souadquzmar/SmartHydroponics/TDS_EC_Arduino_Code_Explanation.docx

# TDS & EC Monitoring

Arduino Mega 2560 | Code explanation for an NFT hydroponic greenhouse growing basil and mint

Purpose: Read the analog TDS module, estimate dissolved-solids concentration and electrical conductivity, display the results, and classify the nutrient solution using five EC bands.

# 1. How the program works

The Arduino reads an analog voltage from the sensor on pin A0. It converts this raw reading into volts, applies a temperature correction, estimates TDS (ppm) using a sensor-specific polynomial, and calculates an estimated EC (mS/cm) using a fixed conversion factor. It then prints the measurements and a status message once per second.

# 2. Sensor connection and constants

Code element | Meaning
TDS_PIN = A0 | The sensor module’s analog signal output is connected to Arduino analog pin A0.
VREF = 5.0 | Assumed analog-to-digital reference voltage in volts. This must match the actual Arduino ADC reference.
ADC_RESOLUTION = 1024.0 | A 10-bit Arduino Mega ADC has 1024 possible values: 0 through 1023.
temperature = 25.0 | Fixed water-temperature assumption, in °C. Replace with a real water sensor reading when available.
tdsFactor = 0.5 | Assumed 500-scale TDS-to-EC conversion factor; this is not universal.

Threshold definitions: EC_LOW_CRITICAL = 1.1, EC_LOW = 1.2, EC_HIGH = 1.5, EC_HIGH_CRITICAL = 1.6. All four are expressed in mS/cm. They are initial project settings for established basil and mint, not measurements made by the sensor.

# 3. setup(): initialization

void setup() {
Serial.begin(9600);
pinMode(TDS_PIN, INPUT);
Serial.println("TDS and EC Monitoring System");
Serial.println("Hydroponics: Basil and Mint");
}

setup() runs once when the board powers on or resets. Serial.begin(9600) starts USB serial communication at 9600 baud; set the Serial Monitor to the same rate. pinMode sets A0 as an input. The two print commands identify the system.

# 4. loop(): converting the sensor reading

int analogValue = analogRead(TDS_PIN);
float voltage = analogValue * VREF / ADC_RESOLUTION;

analogRead(A0) returns an integer from 0 to 1023. Multiplying that reading by 5.0 / 1024 estimates the module output voltage. For the previously observed analog reading 154, the displayed voltage is about 154 × 5 / 1024 = 0.752 V. This is the module’s electrical output, not EC itself.

# 5. Temperature compensation

float compensationCoefficient =
1.0 + 0.02 * (temperature - 25.0);
float compensatedVoltage = voltage / compensationCoefficient;

Conductivity depends on water temperature. The program uses an approximate 2% change per °C around 25°C to normalize the voltage. Because temperature is currently fixed at 25°C, the coefficient equals 1.0: no adjustment is actually made. Use a measured temperature for more realistic compensation; the precise behavior also depends on the sensor and solution.

# 6. Calculating TDS and estimating EC

float tdsValue =
(133.42 * pow(compensatedVoltage, 3)
- 255.86 * pow(compensatedVoltage, 2)
+ 857.39 * compensatedVoltage) * 0.5;
float ecValue = tdsValue / (tdsFactor * 1000.0);

The polynomial estimates TDS in parts per million (ppm) from corrected voltage. Its coefficients are associated with a common analog TDS-module example; they are not a universal physics formula for all probes. pow(x, 3) means x cubed and pow(x, 2) means x squared.

Next, the program computes EC from its estimated TDS. With tdsFactor = 0.5: EC (mS/cm) = TDS (ppm) / 500. Thus 600 ppm corresponds to an estimated 1.2 mS/cm. IMPORTANT: EC is not independently measured by this code; the EC and TDS values are two expressions of the same analog estimate.

# 7. Printing the readings

The Serial.print commands output the raw ADC number, voltage (three decimal places), TDS (one decimal place), and EC (three decimal places). Serial.println adds a line break. The final delay(1000) pauses for approximately 1 second between reports. The numbers are intended for observation and debugging.

# 8. Understanding the if / else if conditions

Condition evaluated in order | Displayed status | Displayed recommendation
EC < 1.1 | CRITICALLY LOW | Add nutrients A and B
1.1 ≤ EC < 1.2 | LOW | Monitor EC / nutrients may be needed
1.2 ≤ EC ≤ 1.5 | OPTIMAL | No adjustment needed
1.5 < EC ≤ 1.6 | HIGH | Stop nutrient dosing
EC > 1.6 | CRITICALLY HIGH | Stop nutrients / check dilution

The program checks each condition from top to bottom and executes only the first matching branch. For example, an EC of 0.557 enters the first branch; an EC of exactly 1.2 enters OPTIMAL; exactly 1.5 is also OPTIMAL; exactly 1.6 is HIGH.

There is no separate TDS condition because the program derives EC directly from TDS using the 0.5 factor. Therefore, separate TDS comparisons would repeat the same classification, rather than add a new independent measurement.

# 9. Worked example from your Serial Monitor

Analog: 154
Voltage: 0.752 V
TDS: 278.4 ppm
EC: 0.557 mS/cm
STATUS: CRITICALLY LOW
ACTION: Add nutrients A and B

The measured EC estimate (0.557) is below the first 1.1 threshold, so the code prints CRITICALLY LOW. If this sample was plain source water rather than a mixed nutrient solution, the status should NOT be treated as an instruction to dose immediately.

# 10. Full annotated code

#define TDS_PIN A0
#define VREF 5.0
#define ADC_RESOLUTION 1024.0

float temperature = 25.0; // Assumed water temperature (C)
float tdsFactor = 0.5; // 500 ppm per 1 mS/cm

#define EC_LOW_CRITICAL 1.1
#define EC_LOW 1.2
#define EC_HIGH 1.5
#define EC_HIGH_CRITICAL 1.6

void setup() {
Serial.begin(9600); // Open Serial Monitor at 9600 baud
pinMode(TDS_PIN, INPUT); // Sensor analog output -> A0
Serial.println("TDS and EC Monitoring System");
Serial.println("Hydroponics: Basil and Mint");
}

void loop() {
int analogValue = analogRead(TDS_PIN); // Read ADC (0-1023)
float voltage = analogValue * VREF / ADC_RESOLUTION;

float compensationCoefficient =
1.0 + 0.02 * (temperature - 25.0);
float compensatedVoltage = voltage / compensationCoefficient;

float tdsValue =
(133.42 * pow(compensatedVoltage, 3)
- 255.86 * pow(compensatedVoltage, 2)
+ 857.39 * compensatedVoltage) * 0.5;
float ecValue = tdsValue / (tdsFactor * 1000.0);

Serial.println("-----------------------------");
Serial.print("Analog: "); Serial.println(analogValue);
Serial.print("Voltage: "); Serial.print(voltage, 3); Serial.println(" V");
Serial.print("TDS: "); Serial.print(tdsValue, 1); Serial.println(" ppm");
Serial.print("EC: "); Serial.print(ecValue, 3); Serial.println(" mS/cm");

if (ecValue < EC_LOW_CRITICAL) {
Serial.println("STATUS: CRITICALLY LOW");
Serial.println("ACTION: Add nutrients A and B");
} else if (ecValue < EC_LOW) {
Serial.println("STATUS: LOW");
Serial.println("ACTION: Monitor EC / nutrients may be needed");
} else if (ecValue <= EC_HIGH) {
Serial.println("STATUS: OPTIMAL");
Serial.println("ACTION: No adjustment needed");
} else if (ecValue <= EC_HIGH_CRITICAL) {
Serial.println("STATUS: HIGH");
Serial.println("ACTION: Stop nutrient dosing");
} else {
Serial.println("STATUS: CRITICALLY HIGH");
Serial.println("ACTION: Stop nutrients / check dilution");
}
Serial.println("-----------------------------");
delay(1000); // Repeat approximately every 1 second
}

# 11. Limitations and next steps

• Calibration: Check the module against a known reference solution; the calculated readings are estimates until calibrated.

• Hardware: This version assumes an Arduino Mega using its default 5 V analog reference. Do not reuse VREF = 5.0 unchanged on an ESP32.

• Sampling: A single analogRead each second can be noisy. For control use, average or median-filter several measurements.

• Temperature: Replace the hard-coded 25°C with a real water-temperature sensor.

• Actuators: The displayed ACTION lines are only text. This program does not operate any nutrient-dosing pumps or relays.

• Safety: Before automating nutrient pumps, add mixing delays, water-level and flow checks, maximum dose/time limits, and hysteresis to prevent rapid toggling.

• Plant stage: The 1.2–1.5 mS/cm band is a reasonable starting target for established plants sharing a reservoir; seedlings may require a weaker solution.

Key takeaway: analog voltage → temperature-adjusted voltage → estimated TDS → estimated EC → status and advisory message. Calibration and safeguards are needed before using the result to control dosing automatically.

Smart Hydroponic Greenhouse | Arduino TDS / EC sensor guide
