souadquzmar/SmartHydroponics/YF_S401_Calibration_and_Flow_Monitoring.docx

# YF-S401 Water Flow Sensor

Calibration, water-flow calculation and Arduino Mega 2560 monitoring

Smart Hydroponic Greenhouse | Experimental record

# 1. Purpose and operating principle

The YF-S401 is a turbine-based Hall-effect water-flow sensor. Water moving through its body rotates an internal rotor; the output generates pulses that the Arduino counts. Pulse frequency increases with flow rate. This project measures circulation flow and prints a warning to the Serial Monitor when it falls below a provisional threshold.

The calibration below is based on one actual collection experiment. It is an initial empirical estimate, not a verified manufacturer calibration across all flow rates.

# 2. Sensor wiring to the Arduino Mega

YF-S401 connection (typical 3-wire model) | Arduino Mega 2560 | Purpose
Red / VCC | 5 V | Supply; verify label/datasheet
Black / GND | GND | Common ground
Yellow / signal | Digital pin 2 | Pulse input with interrupt

Check the specific sensor wire markings before applying power. Pin 2 is interrupt-capable on the Mega. The sketch enables the internal pull-up and counts FALLING signal edges; pulse counting should be verified by passing water through the sensor. Keep the flow direction consistent with the arrow on the sensor body.

# 3. Recorded calibration experiment

Quantity | Measured value
Collected volume, V | 1.00 L
Counted pulses, N | 2,485 pulses
Elapsed collection time, t | 43.27 s

Procedure: Prime the sensor to remove air, establish steady flow, start pulse counting at the same moment collection begins, collect exactly 1.00 L, stop collection and counting together, and record pulses and time. Multiple trials should be conducted because timing/volume uncertainty and flow-dependent sensor behavior affect the result.

# 4. Calibration equations and worked calculations

## 4.1 Pulses per liter

P = N / V

P = 2485 pulses / 1.00 L = 2485 pulses/L

## 4.2 Calibration factor used by the sketch

Frequency f (Hz) = K × flow Q (L/min), so Q = f / K.

A flow of 1 L/min is 1/60 L/s; therefore K = P / 60 = N / (60 × V).

K = 2485 / (60 × 1.00) = 41.4167 ≈ 41.42 Hz per (L/min).

Use the following Arduino setting: const float CALIBRATION_FACTOR = 41.42f;

## 4.3 Flow rate from volume and elapsed time

Q = (V / t) × 60

Q = (1.00 / 43.27) × 60 = 1.3866 ≈ 1.39 L/min

Hourly flow = Q × 60 ≈ 83.20 L/h.

## 4.4 Cross-check from pulse frequency

f = N / t = 2485 / 43.27 ≈ 57.43 Hz

Q = f / K ≈ 57.43 / 41.4167 ≈ 1.39 L/min.

## 4.5 Converting pulses collected in a timed Arduino sample

For a sample duration Δt in milliseconds: f = pulses × 1000 / Δt.

Flow (L/min) = (pulses × 1000 / Δt) / 41.42.

The code uses actual elapsed milliseconds rather than assuming exactly one second.

# 5. Monitoring behavior and warning threshold

The sketch reads and resets the interrupt pulse counter approximately once per second, calculates the corresponding flow, and prints status to the USB Serial Monitor at 9600 baud.

Condition | Serial output
No pulses in sample | WARNING: NO WATER FLOW DETECTED!
Positive flow below 1.00 L/min | WARNING: LOW WATER FLOW!
Flow at least 1.00 L/min | Water flow is normal.

The 1.00 L/min minimum is a placeholder for initial testing, not a validated nutrient-film-technique (NFT) requirement. Determine the minimum safe total flow from pump performance, channel count, and actual distribution. Zero pulses indicates no detected pulses during the sampling interval; it does not establish why (e.g., stopped pump, disconnected signal, or flow below the sensor’s detection range).

# 6. Upload and verification

1. Connect the sensor to Mega 5 V, GND and digital pin 2 after checking its pinout.
2. Open YF_S401_Flow_Monitor_Mega.ino in Arduino IDE. Select Arduino Mega or Mega 2560, its correct port, and upload.
3. Open Tools > Serial Monitor and select 9600 baud.
4. Run the pump and verify the flow value is positive. Reduce flow only if safe for the pump; look for a low-flow warning.
5. Stop flow safely and verify the no-flow warning. If pulses remain at zero during normal flow, check wiring, flow direction, signal polarity and sensor minimum working range.

# 7. Next calibration checks and limitations

Repeat the 1.00 L collection at least twice and calculate K for each test. If the factors are consistent, use their mean. For an NFT greenhouse, also test at flow rates near the planned alarm threshold: an empirical K from a single 1.39 L/min test may not transfer accurately to substantially lower flows.

Suggested log: test number | collected volume (L) | total pulses | time (s) | K | calculated flow (L/min).

Optional future improvements: require low flow for five consecutive seconds before alarming; suppress expected no-flow warnings while the circulation pump is intentionally OFF; relay measurements to the ESP32 for dashboard monitoring. These features are not yet included in the supplied starter sketch.

# 8. Arduino sketch

The complete, ready-to-upload .ino file is supplied separately. Main editable parameters: CALIBRATION_FACTOR = 41.42f, MINIMUM_FLOW_LPM = 1.00f, FLOW_SENSOR_PIN = 2, and SAMPLE_INTERVAL_MS = 1000UL.

Example serial output: Pulses: 58 | Flow: 1.40 L/min | Water flow is normal.

Smart Hydroponic Greenhouse • YF-S401 calibration test
