souadquzmar/SmartHydroponics/(commit log)

2026-10-14 water pump
2026-10-18 YF-S401 water flow monitoring code
2026-10-18 sensors testing codes
2026-10-21 water flow sensor + water pump
2026-11-02 update flow sensor
